dw2wrigh/noise-toaster/README.md

# noise-toaster
My version of the MFOS Noise Toaster
