dw2wrigh/noise-toaster/Documents/Parts List.xlsx

Qty. | Description | Value | Actual Part | Designators
2 | LM324 Quad Low Power Op Amp | LM324 | LM324DT | U1, U2
1 | LM386N4 (or N3) Low Voltage Audio Power Amp | LM386 | LM386MX | U3
1 | 2N3906 | 2N3906 | MMBT3906 | Q10
4 | 2N5457 N Channel JFET | 2N5457 | MMBF5457 | Q1, Q7, Q8, Q9
5 | Transistor NPN 2N3904 | 2N3904 | MMBT3904 | Q2, Q3, Q4, Q5, Q6
3 | 1N914 High Speed Sw. Diode | 1N914 | 1N4448WS | D1, D2, D3
1 | General Purpose Red LED | LED | C503B-RAS-CA0C0AA1 | LED1
7 | Linear Taper Potentiometer | 100K | PDB181-E420K-104B-ND‎ | R1, R13, R20, R28, R29, R38, R66
3 | Linear Taper Potentiometer | 1M | ‎PDB181-E420K-105B-ND‎ | R49, R51, R53
3 | Resistor 1/4 Watt 5% | 2M | ‎ESR03EZPJ | R5, R16, R30
1 | Resistor 1/4 Watt 5% | 300K | ‎ESR03EZPJ | R7
1 | Resistor 1/4 Watt 5% | 36K | ‎ESR03EZPJ | R21
1 | Resistor 1/4 Watt 5% | 15K | ‎ESR03EZPJ | R18
2 | Resistor 1/4 Watt 5% | 39K | ‎ESR03EZPJ | R39, R40
3 | Resistor 1/4 Watt 5% | 3K | ‎ESR03EZPJ | R48, R65, R70
5 | Resistor 1/4 Watt 5% | 4.7K | ‎ESR03EZPJ | R22, R23, R37, R42, R54
2 | Resistor 1/4 Watt 5% | 4.7M | ‎ESR03EZPJ | R33, R35
3 | Resistor 1/4 Watt 5% | 470K | ‎ESR03EZPJ | R10, R19, R41
2 | Resistor 1/4 Watt 5% | 47K | ‎ESR03EZPJ | R27, R36
2 | Resistor 1/4 Watt 5% | 75K | ‎ESR03EZPJ | R2, R56
1 | Resistor 1/4 Watt 5% | 820 ohm | ‎ESR03EZPJ | R50
1 | Resistor 1/4 Watt 5% | 10 ohms | ‎ESR03EZPJ | R69
12 | Resistor 1/4 Watt 5% | 100K | ‎ESR03EZPJ | R14, R24, R25, R31, R44, R45, R47, R55, R58, R59, R60, R67
11 | Resistor 1/4 Watt 5% | 10K | ‎ESR03EZPJ | R4, R6, R9, R12, R15, R17, R26, R32, R52, R61, R62
2 | Resistor 1/4 Watt 5% | 150K | ‎ESR03EZPJ | R63, R64
1 | Resistor 1/4 Watt 5% | 3M | ‎ESR03EZPJ | R34
2 | Resistor 1/4 Watt 5% | 1M | ‎ESR03EZPJ | R8, R46
1 | Resistor 1/4 Watt 5% | 200 ohm | ‎ESR03EZPJ | R57
2 | Resistor 1/4 Watt 5% | 20K | ‎ESR03EZPJ | R68, Extra for optional R56 replacement.
1 | Resistor 1/4 Watt 5% | 270K | ‎ESR03EZPJ | R3
1 | Resistor 1/4 Watt 5% | 27K | ‎ESR03EZPJ | R43
1 | Resistor 1/4 Watt 5% | 2K | ‎ESR03EZPJ | R11
2 | Capacitor Aluminum Bipolar (non polarized) | 1uF | EEE-1HA010NR | C17, C21
3 | Capacitor Ceramic | .001uF | 885012206083‎ | C2, C9, C10
1 | Capacitor Ceramic | .047uF | CL10B473KB8NNNC‎ | C24
8 | Capacitor Ceramic | .1uF | CL10B104KB8NNNC‎ | C3, C4, C5, C7, C8, C11, C12, C20
1 | Capacitor Ceramic | 100pF | 885012206077‎ | C1
1 | Capacitor Ceramic | .01uF | 885012206089 | C6
3 | Capacitor Electrolytic | 10uF | 865080440002 | C13, C14, C25
2 | Capacitor Electrolytic | 1uF | ‎865060640001‎ | C16, C19
1 | Capacitor Electrolytic | 4.7uF | ‎865080640004‎ | C18
1 | Capacitor Electrolytic Radial Lead 0.2" Spacing | 220uF | UCL1C221MCL1GS‎ | C22
3 | Capacitor Electrolytic Radial Lead 0.2" Spacing | 470uF | 865080353015‎ | C15, C23, C26
1 | Speaker 2 1/4 inch 8 ohm | 8 ohm 1W | ‎K 50 FL - 8 OHM‎ | SPK1
2 | Switch SPDT (Center Off) Mini Toggle | SPDT | 100SP3T1B1M1QEH | S3, S6
2 | Switch SPDT Mini Toggle | SPDT | 100SP1T1B1M1QEH | S8, S9
6 | Switch SPST Mini Toggle | SPST | 100SP1T1B1M1QEH | S1, S2, S4, S5, S7, S11
1 | Switch SPST N.O. Pushbutton | SPST | ‎PS1024ARED‎ | S10
1 | Jack 1/4" With NC Switch to Tip |  | ‎35PM2A‎ | J1
1 | Battery | 9V Battery | BX0023 | B1
