dw2wrigh/noise-toaster/Documents/Front Panel RefDes.pdf

### Voltage Controlled Oscillator

### Voltage Controlled Low Pass Filter

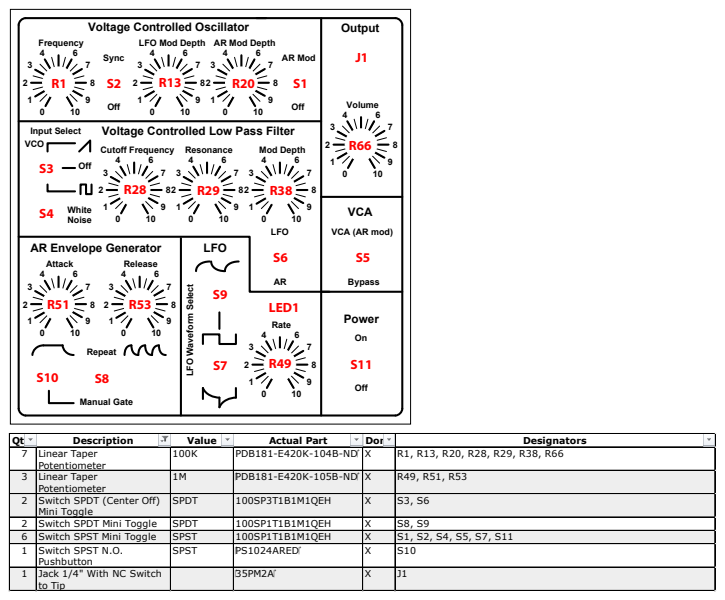
[picture p4: page 1]

Qty. | Description | Value | Actual Part | Done | Designators
7 | Linear Taper Potentiometer | 100K | PDB181-E420K-104B-ND‎ | X | R1, R13, R20, R28, R29, R38, R66
3 | Linear Taper Potentiometer | 1M | ‎ PDB181-E420K-105B-ND‎ | X | R49, R51, R53
2 | Switch SPDT (Center Off) Mini Toggle | SPDT | 100SP3T1B1M1QEH | X | S3, S6
2 | Switch SPDT Mini Toggle | SPDT | 100SP1T1B1M1QEH | X | S8, S9
6 | Switch SPST Mini Toggle | SPST | 100SP1T1B1M1QEH | X | S1, S2, S4, S5, S7, S11
1 | Switch SPST N.O. Pushbutton | SPST | ‎ PS1024ARED‎ | X | S10
1 | Jack 1/4" With NC Switch to Tip | | ‎ 35PM2A‎ | X | J1
