dw2wrigh/noise-toaster/Documents/Laser Cutter/Art.pdf

### Voltage Controlled Oscillator Output

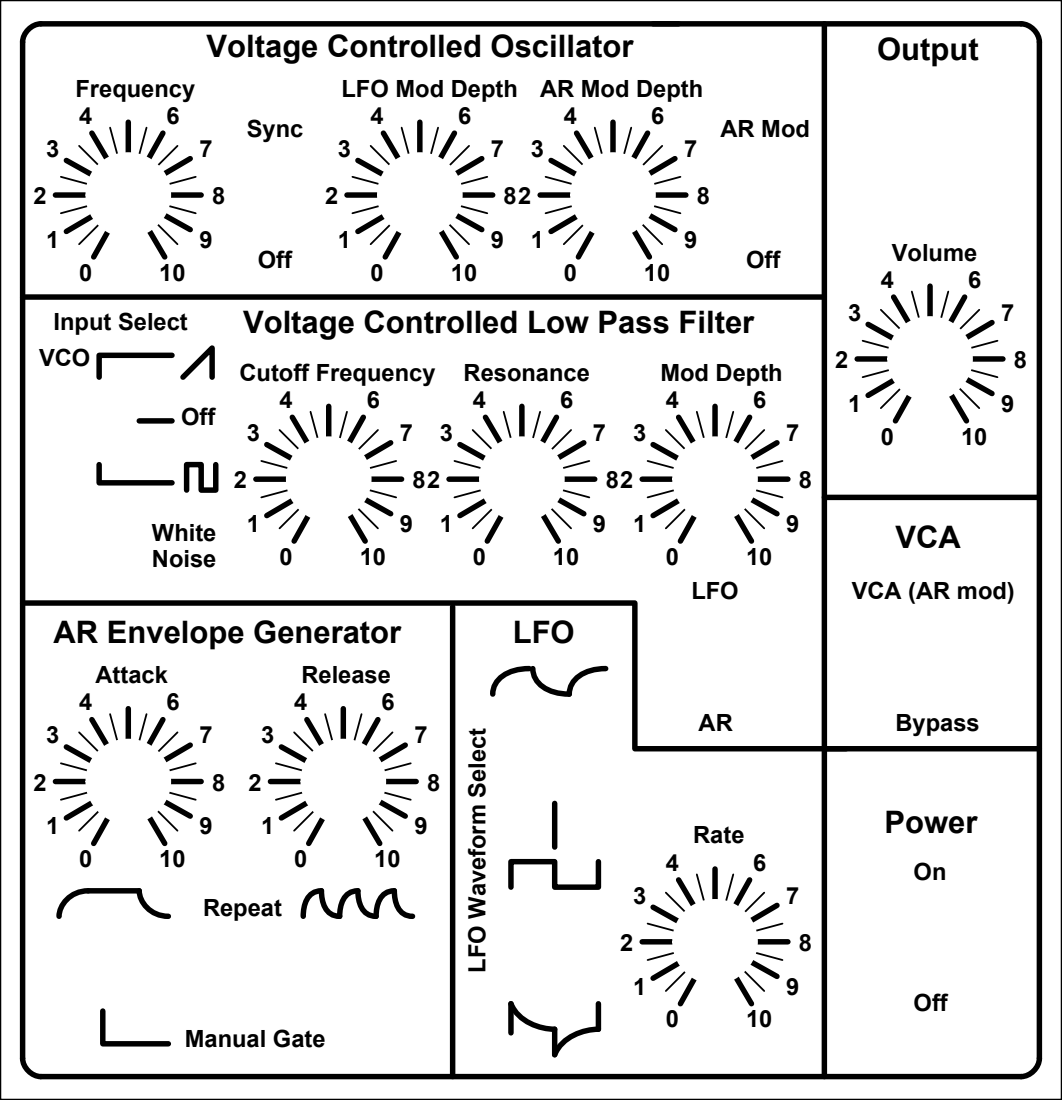
[picture p5: page 1]
LFO; Off; White Noise; VCA (AR mod); Bypass; VCO; Input Select; Sync; AR Mod; AR Envelope Generator; Power; Voltage Controlled Low Pass Filter; VCA; Manual Gate; Repeat; LFO Mod Depth; Cutoff Frequency; Resonance; Mod Depth; Rate; Volume; Release; AR Mod Depth; Frequency; Attack

LFO Waveform Select
