dw2wrigh/noise-toaster/Project Outputs for Noise Toaster/Noise Toaster Schematics.pdf

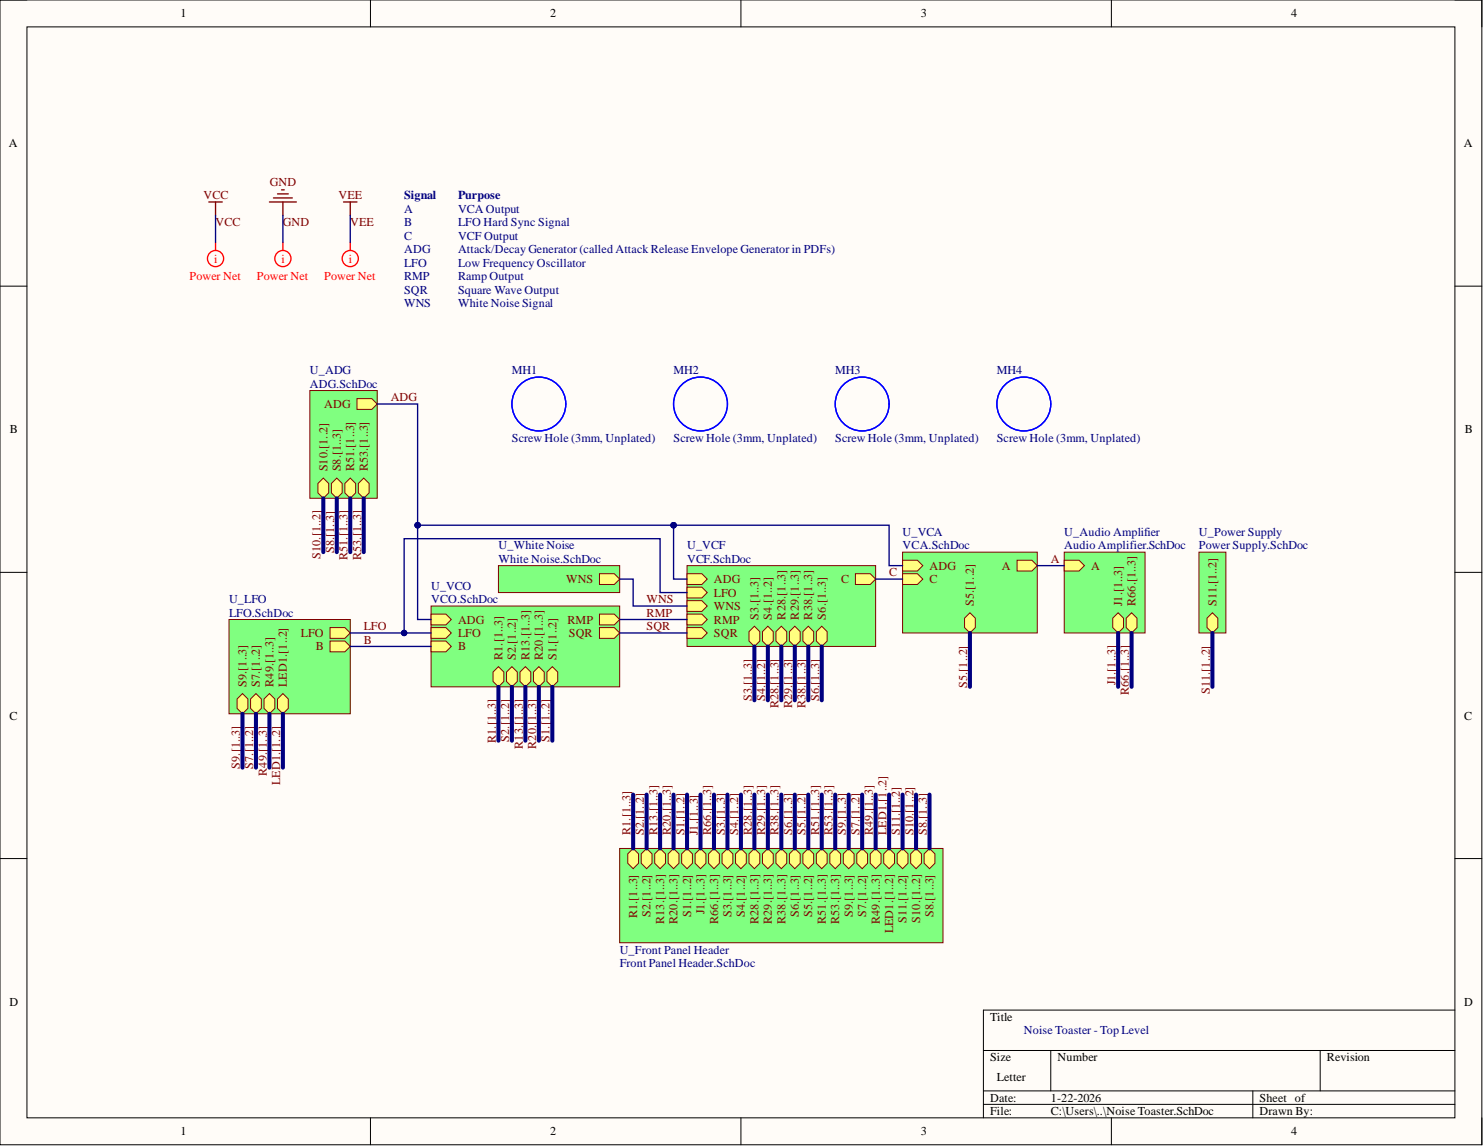
[picture p6: page 1]

VCA Output
LFO Hard Sync Signal
VCF Output
Attack/Decay Generator (called Attack Release Envelope Generator in PDFs)
Low Frequency Oscillator
Ramp Output
Square Wave Output
White Noise Signal

U_White Noise White Noise.SchDoc

U_VCF

U_Front Panel Header
Front Panel Header.SchDoc

Title
Noise Toaster - Top Level

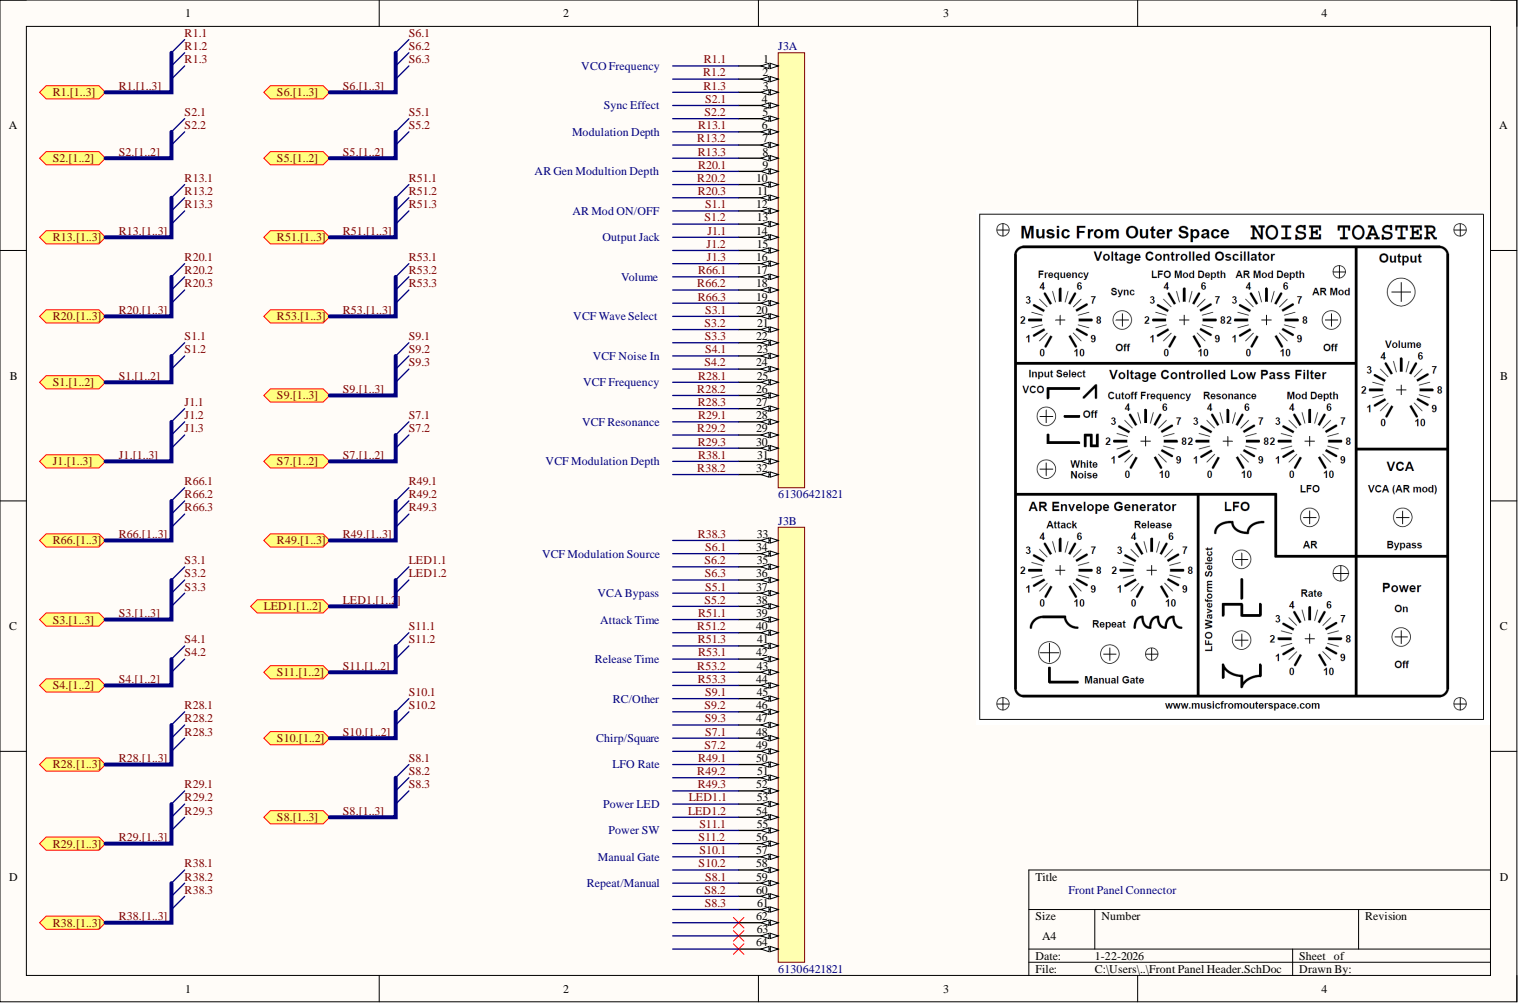
[picture p7: page 2]

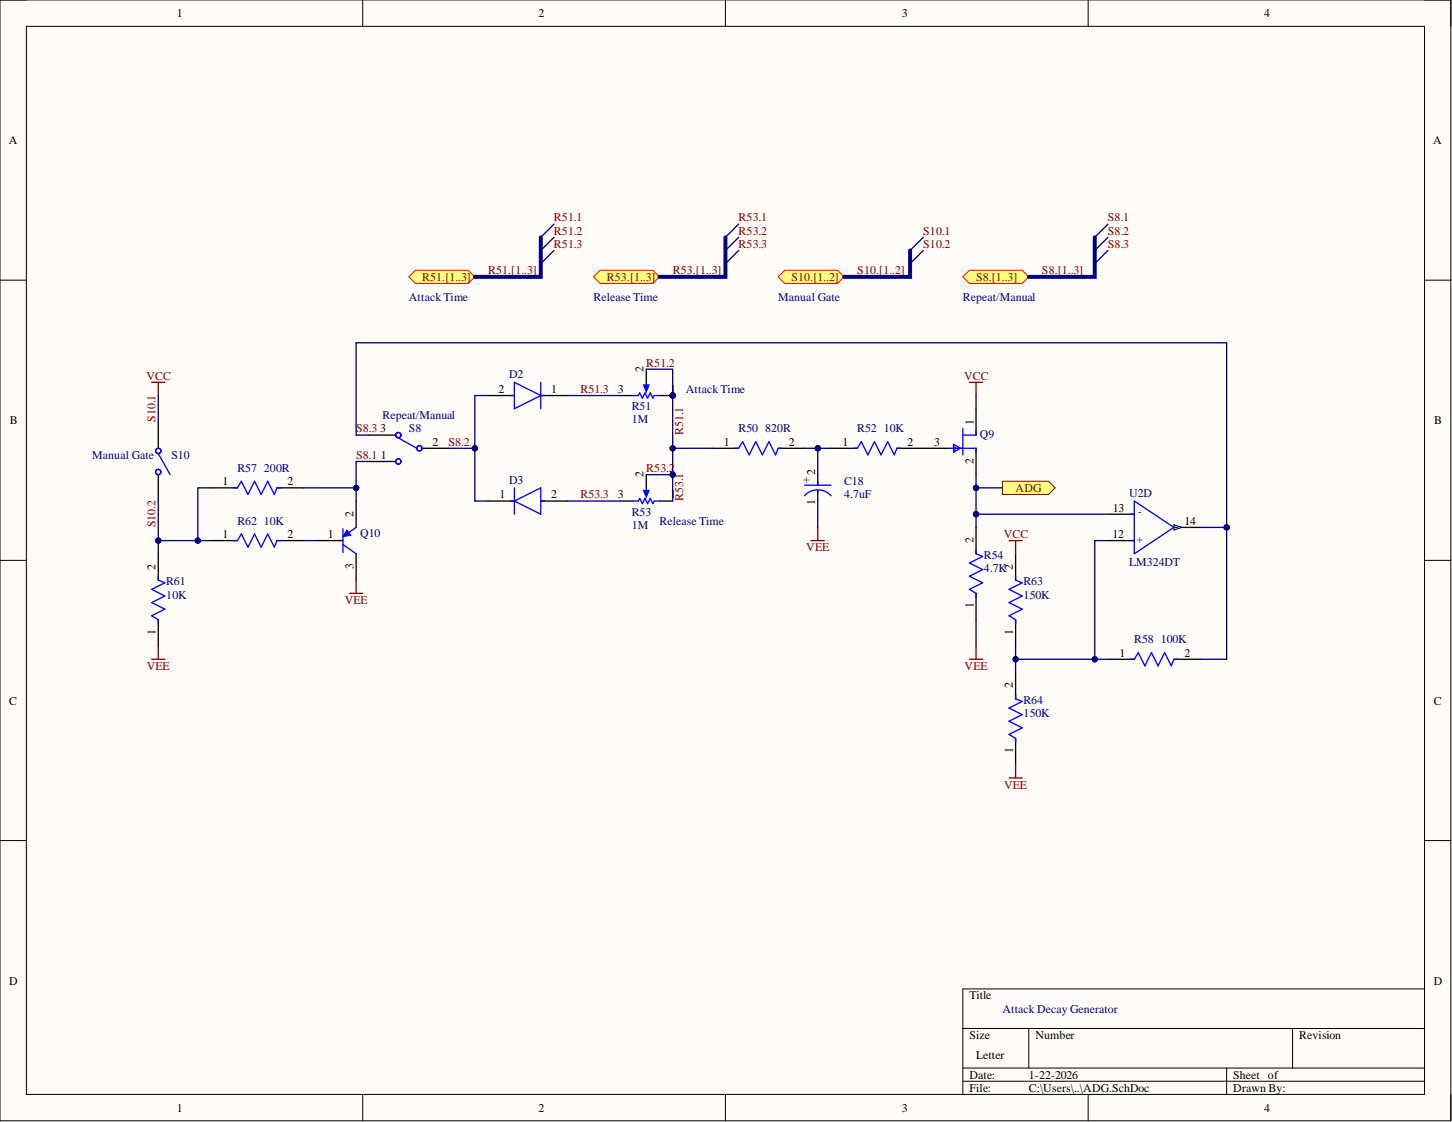
[picture p8: page 3]

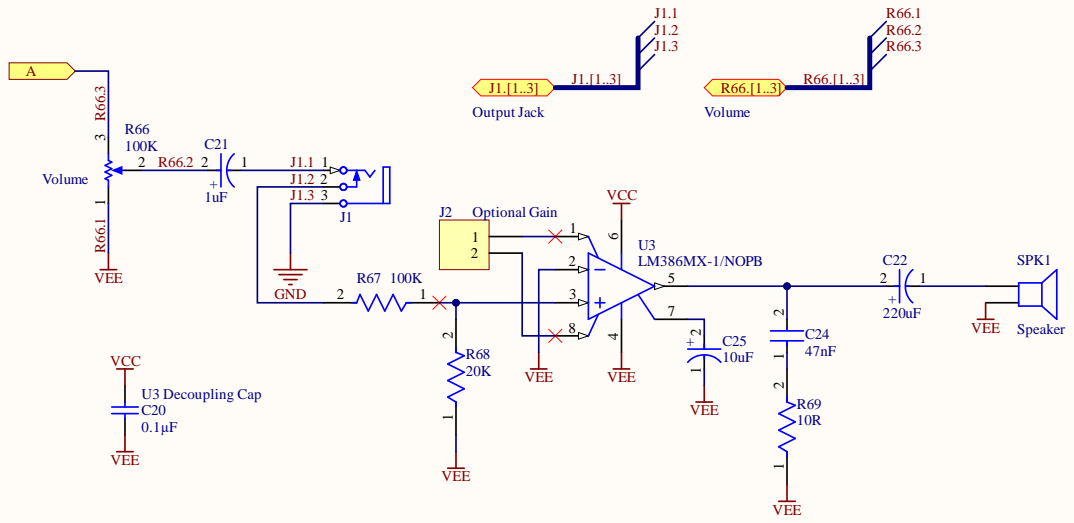
[picture p9: page 4]

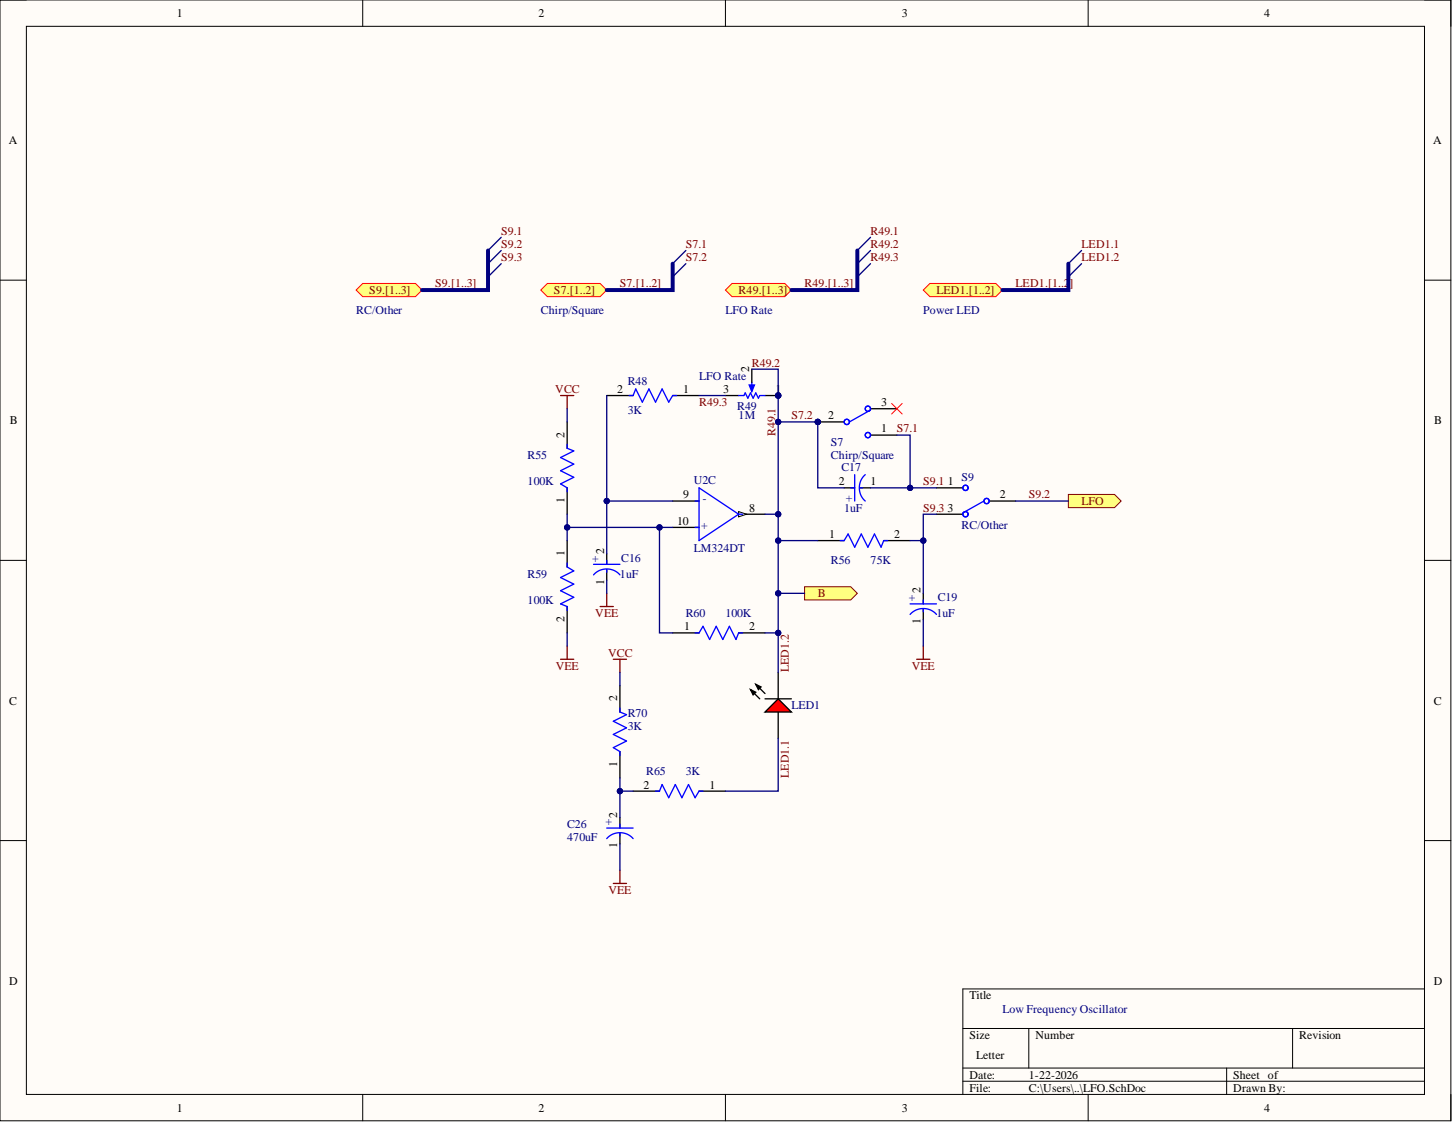
[picture p10: page 5]

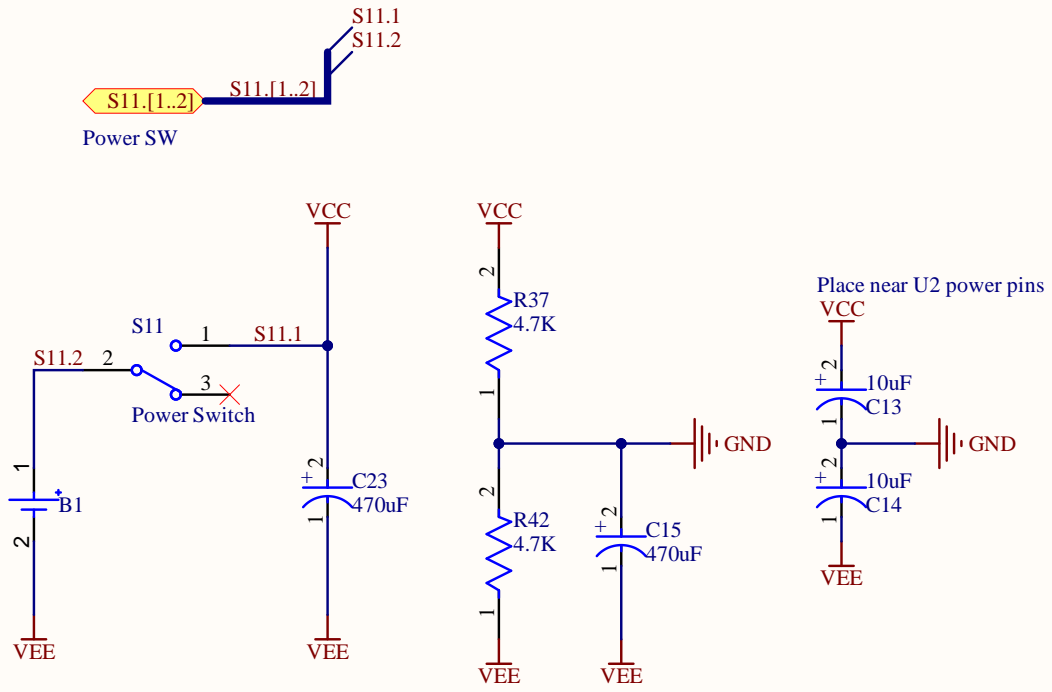
[picture p11: page 6]

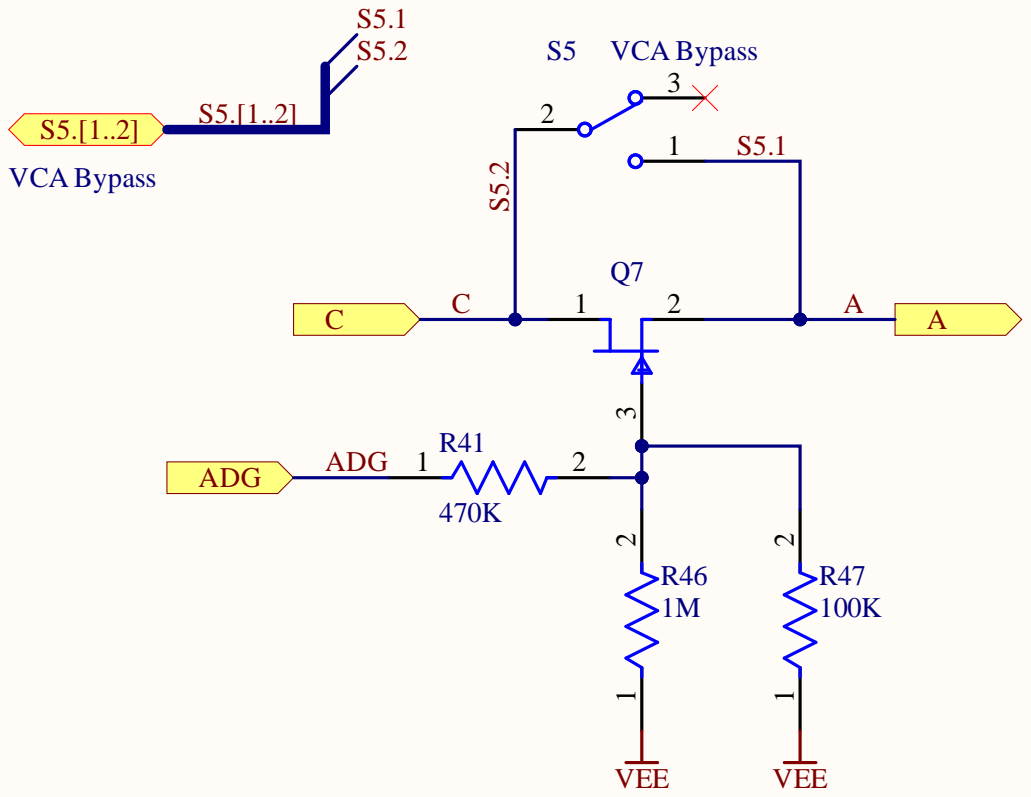
[picture p12: page 7]

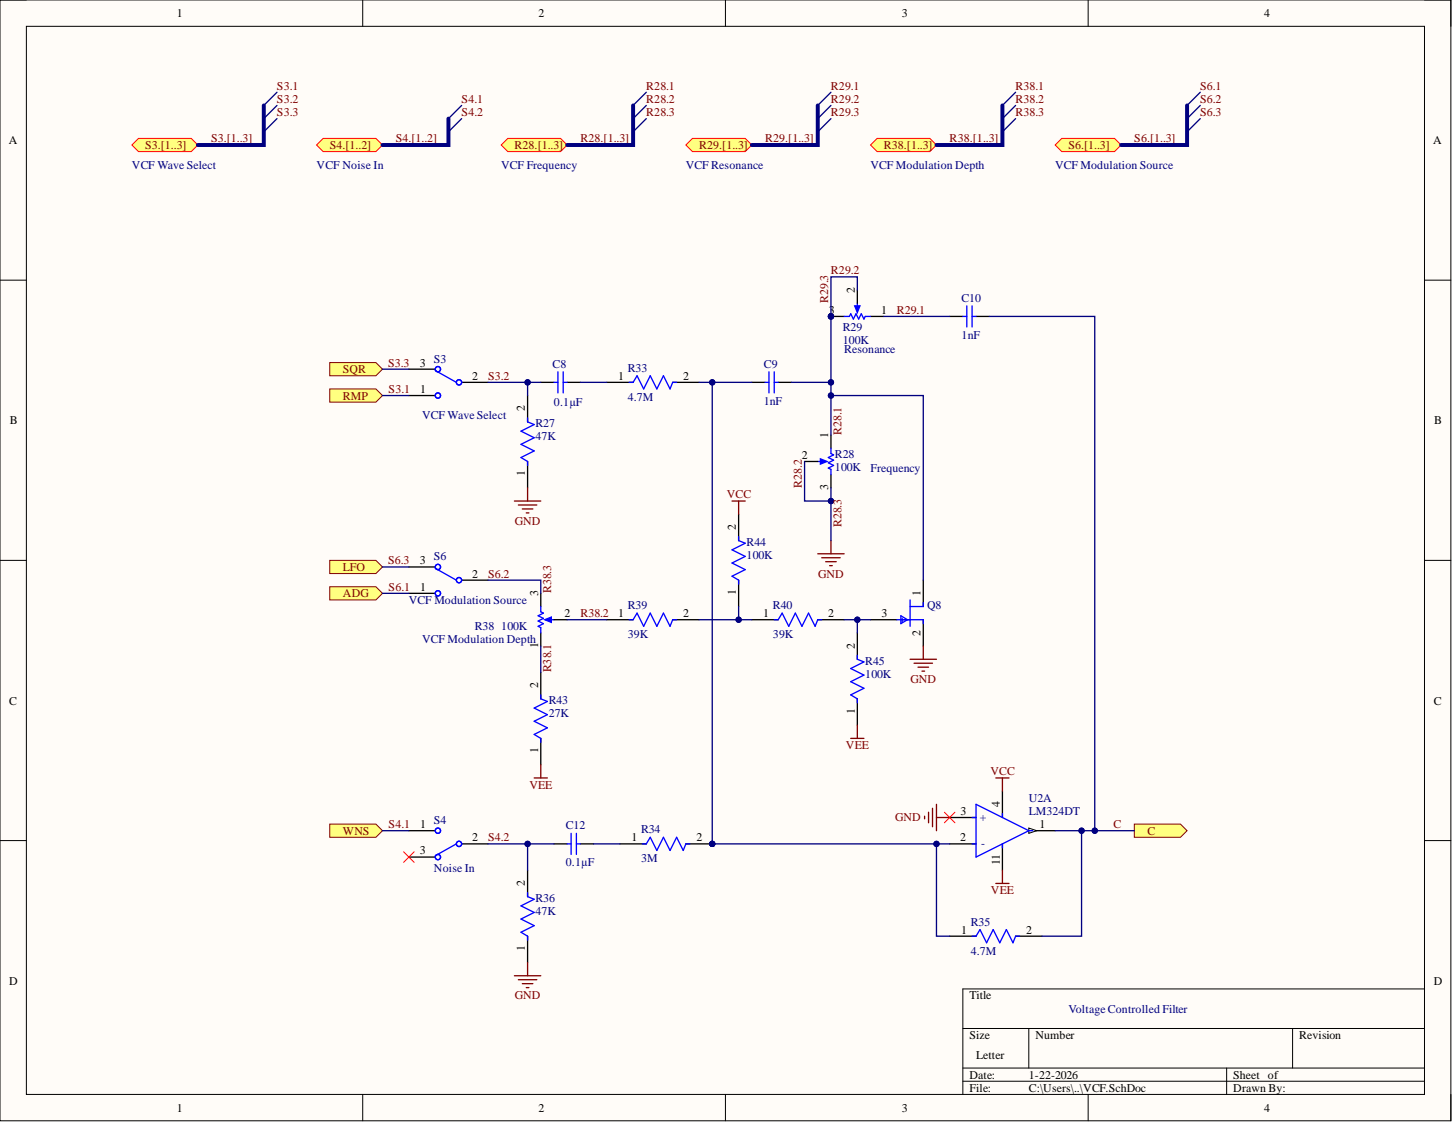
[picture p13: page 8]

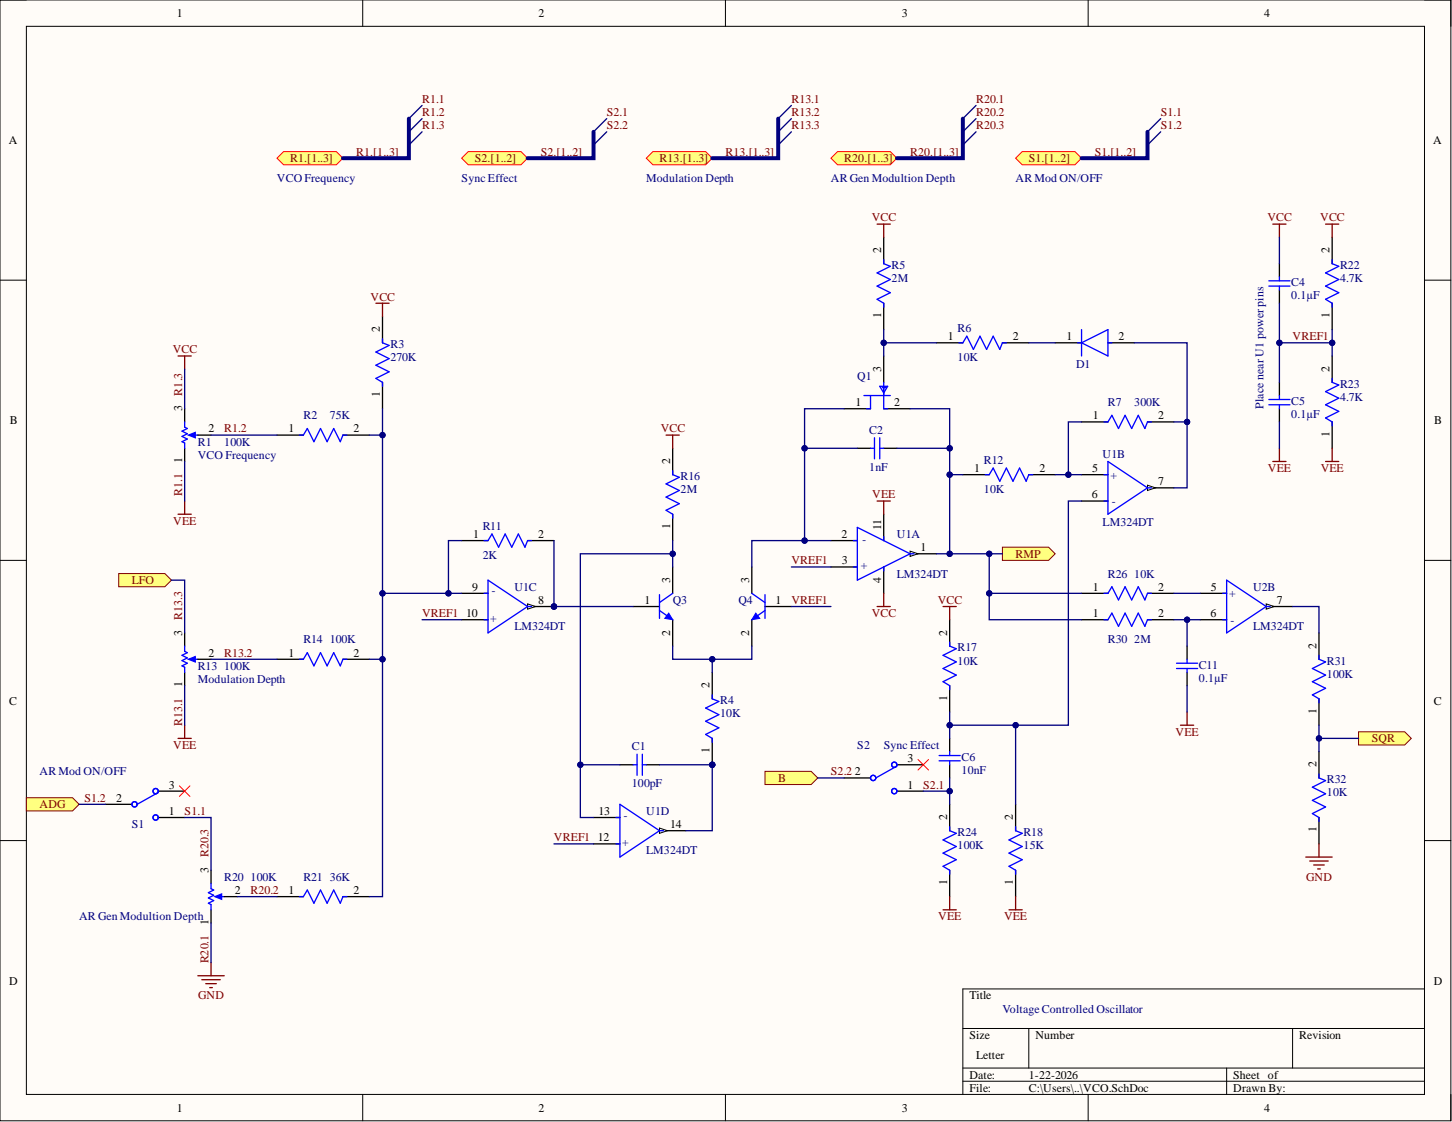
[picture p14: page 9]

Place near U1 power pins

AR Mod ON/OFF

AR Gen Modultion Depth

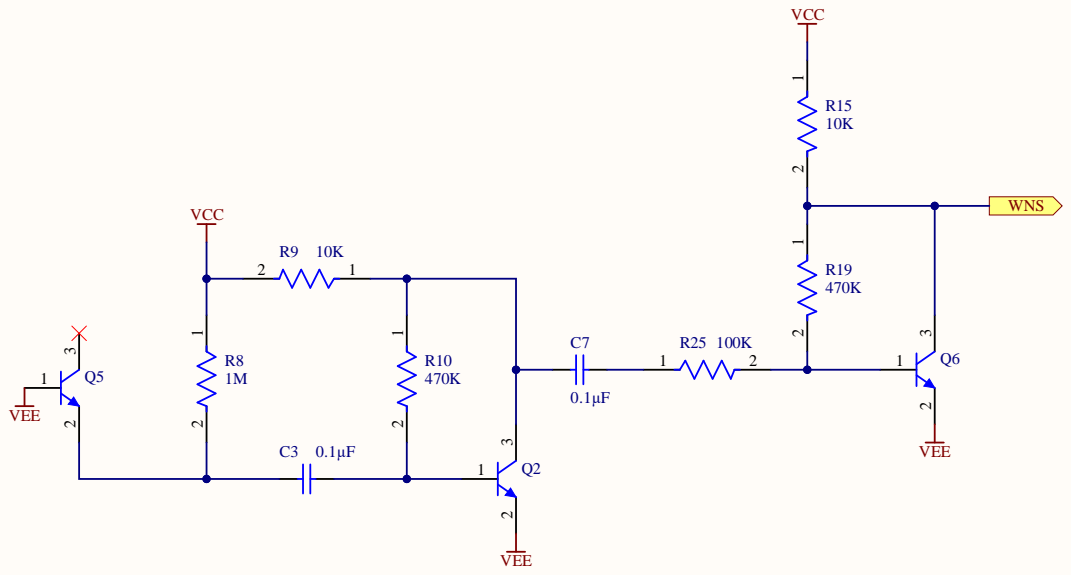
[picture p15: page 10]
