dw2wrigh/noise-toaster/Project Outputs for Noise Toaster/Composite Drawing.pdf

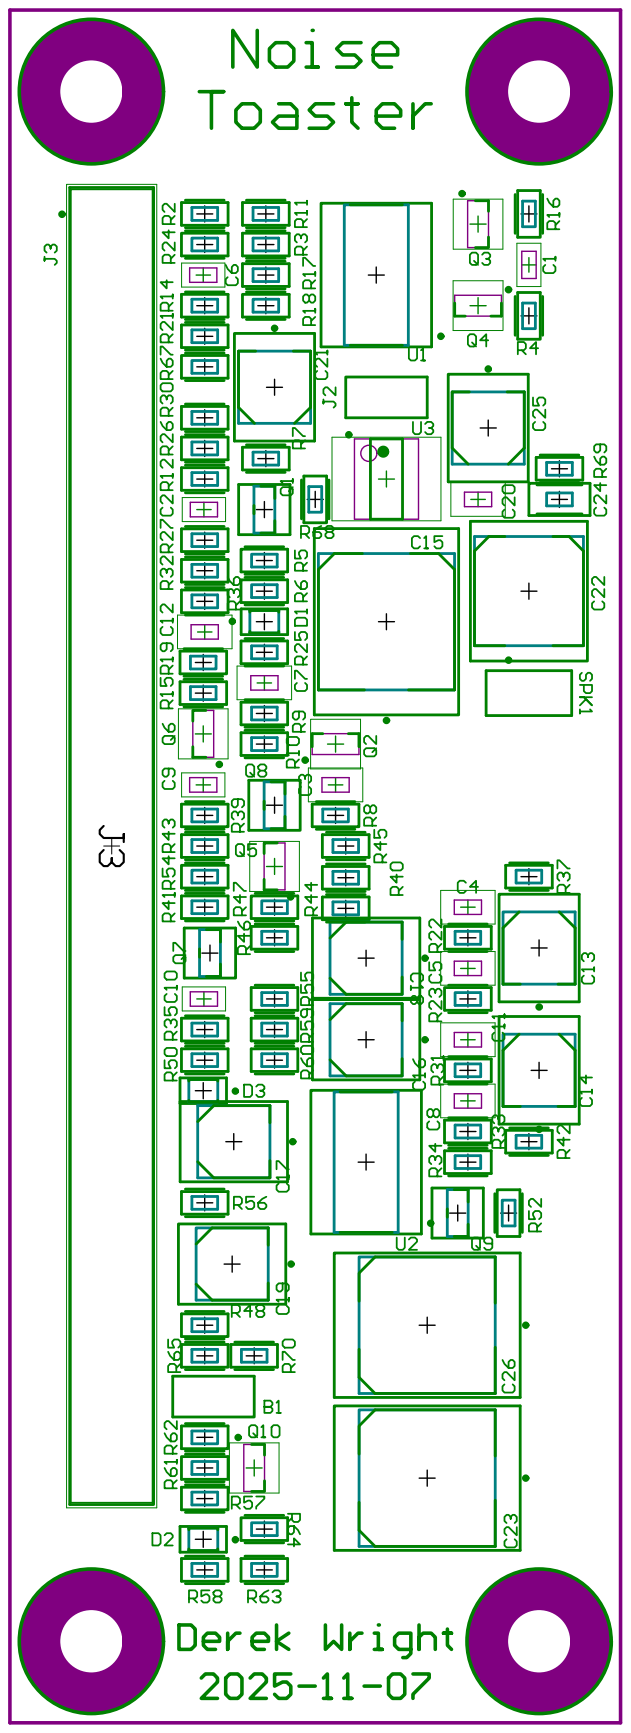
[picture p16: page 1]
