dw2wrigh/noise-toaster/Documents/Laser Cutter/Cutout.pdf

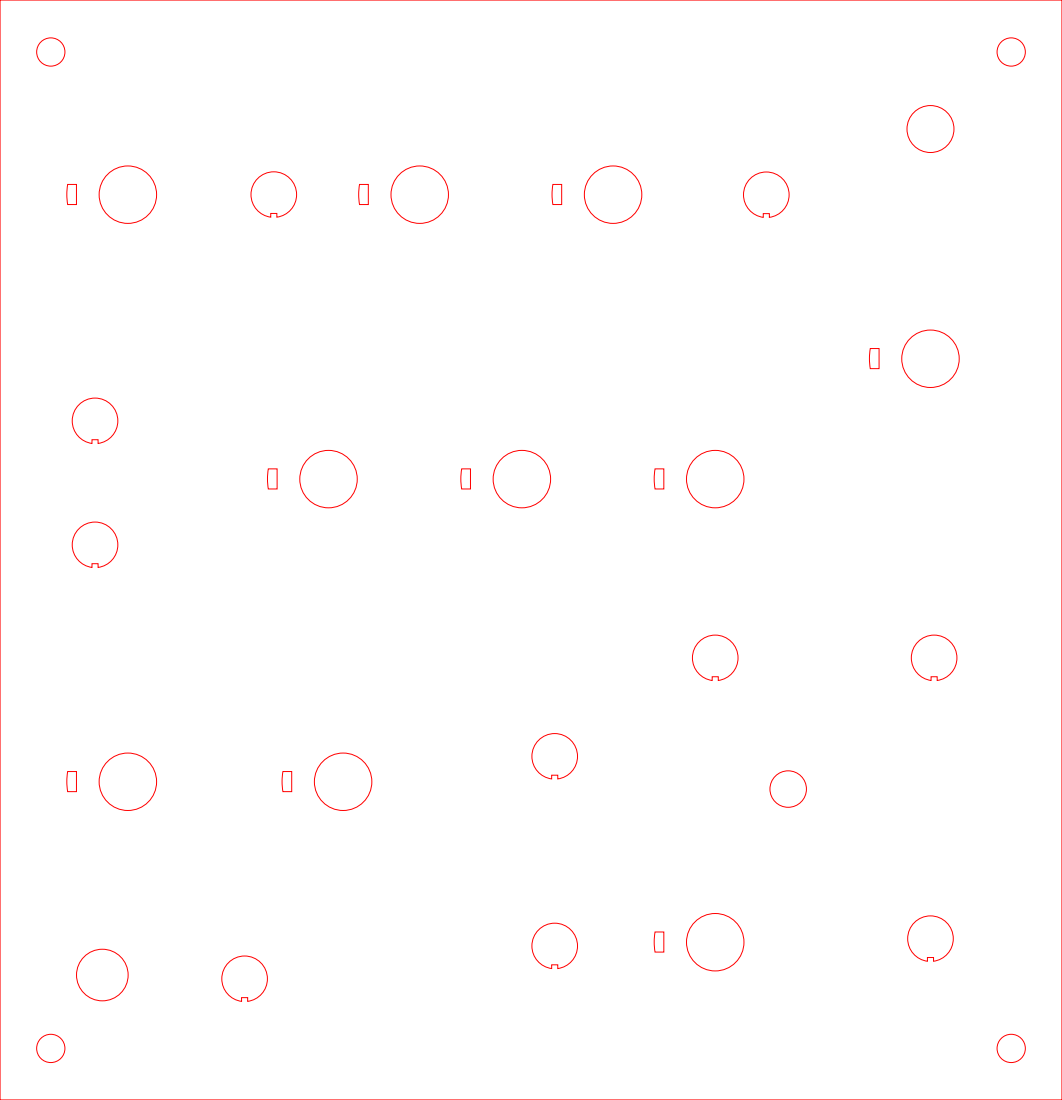
[picture p17: page 1]
