dw2wrigh/noise-toaster/Documents/Analysis/ADG TB.asc

V1: voltage; 4.5
V2: voltage; 4.5
V3: voltage; 1
V4: voltage; PULSE(0 1 500m 10u 10u 500m 1 8)
X1: ADG; PR51={PR51} PR53={PR53}
Named nets: VCC, VEE, 0, S10, S8, ADG
.tran 0 8 0 1m
.op
.param PR51=0.01 PR53=0.01
