dw2wrigh/noise-toaster/Documents/Analysis/ADG.asc

C18: cap; 4.7µ
D2: diode; 1N914
D3: diode; 1N914
Q9: njf; J113
Q10: pnp; 2N3906
R50: res; 820
R51: res; {RMIN + 1Meg*PR51}
R52: res; 10k
R53: res; {RMIN + 1Meg*PR53}
R54: res; 4.7k
R57: res; 200
R58: res; 100k
R61: res; 10k
R62: res; 10k
R63: res; 150k
R64: res; 150k
S8: spdt
S10: spdt
U2D: LT1014
Named nets: VCC, VEE, S10, S8, ADG, Q9G, Vp, Vo, ChDis
.include spdt.sub
S8 = 0: Automatic
S8 = 1: Manual via S10
 
S10: Manual ADG Gate
1Meg Pot
1Meg Pot
.param RMIN = 1
