dw2wrigh/noise-toaster/Documents/Analysis/Amplifier TB.asc

V1: voltage; 4.5
V2: voltage; 4.5
V3: voltage; SINE(0 1 100 0.01); AC 1
X1: Amplifier; PR66={PR66}
Named nets: VCC, VEE, 0, A, OUT
.tran 0 0.1 0 startup
.op
.param PR66=0.5
.options method=gear
.ac dec 10 0.1 1Meg
.step param PR66 0 1 0.1
