dw2wrigh/noise-toaster/Documents/Analysis/Amplifier.asc

C21: cap; 1µ
C22: cap; 220µ
C24: cap; 47n
C25: cap; 10µ
CM: cap; 137µ
LE: ind; 150µ; Rser=1m
LM: ind; 1m; Rser=1m
R66N: res; {RMIN + 100k*PR66}
R66P: res; {RMIN + 100k*(1-PR66)}
R67: res; 100k
R68: res; 20k
R69: res; 10
RE: res; 6.4
RM: res; 22
U1: LM386
Named nets: VCC, VEE, A, OUT
CHANGE: Improve low-freq response
.include LM386.sub
Speaker Model for 2056-K50FL-8OHM-ND
.param RMIN=1
