dw2wrigh/noise-toaster/Documents/Analysis/LFO TB.asc

V1: voltage; 4.5
V2: voltage; 4.5
V3: voltage; 1
V4: voltage; 0
X1: LFO; PR49VAL={PR49}
Named nets: VCC, VEE, 0, S9, S7, LFO, B
.tran 0 8 0 1m
.op
.param PR49=0.1
.step param PR49 0 1 0.1
