dw2wrigh/noise-toaster/Documents/Analysis/LFO.asc

C16: cap; 1µ
C17: cap; 1µ
C19: cap; 1µ
C26: cap; 470µ
LED1: LED; QTLP690C
R48: res; 3k
R49: res; {RMIN+ (1-PR49)*1Meg}
R55: res; 100k
R56: res; 75k
R59: res; 100k
R60: res; 100k
R65: res; 3k
R70: res; 3k
S7: spdt
S9: spdt
U2C: LT1014
Named nets: S7, S9, VCC, VEE, Vp, Vn, B, LFO
.param RMIN = 1
S7 = 0: Square
S7 = 1: Chirp
 
S9 = 0: Other
S9 = 1: RC
 
R49: LFO Frequency
.include spdt.sub
