dw2wrigh/noise-toaster/Documents/Analysis/NoiseToaster.asc

X1: ADG; PR51={PR51} PR53={PR53}
X2: LFO; PR49={PR49}
X3: VCO; PR1={PR1} PR13={PR13} PR20={PR20}
X4: WhiteNoise
X5: VCF
X6: VCA
X7: Amplifier; PR66={PR66}
Named nets: VCC, VEE, S1, S2, S3, S4, S5, S6, S7, S9, S8, S10, OUT, A, C, ADG, LFO, B, RMP, SQR, WNS
S1: VCO AR Mod Enable
0 = OFF
1 = ON
 
S2: VCO Sync Effect (via B)
0 = OFF
1 = ON
 
S3: VCF Wave Select
0   = Square
0.5 = None
1   = Ramp
 
S4: VCF White Noise In
0 = OFF
1 = ON
 
S5: VCA Enable
0 = Enabled
1 = Bypass
 
S6: VCF Modulation Source
0   = Low Frequency Oscillator
0.5 = None
1   = Attack Delay Generator
 
(S9, S7): LFO Output
00 = Square
01 = Chirp
1X = RC
 
S8: ADG Trigger
0 = Automatic Repeat
1 = Manual via S10
 
S10: ADG Manual Gate
R1:  VCO Frequency
R13: VCO LFO Modulation Depth
R20: VCO AR Modulation Depth
 
R51: ADG Attack Time
R53: ADG Release Time
 
R49: LFO Rate
 
R28: VCF Cutoff Frequency
R29: VCF Resonance
R38: VCF Modulation Depth
 
R66: Volume
.param PR51 = 0.1
.param PR53 = 0.1
.param PR1 = 0.6
.param PR13 = 0.1
.param PR20 = 1
.options method=gear
.options reltol=0.002 abstol=1n vntol=1u
.param PR28 = 1.0
.param PR29 = 0.9
.param PR38 = 1
.param PR49 = 0.9
.param PR66 = 1.0
.param S1v = 0
.param S2v = 0
.param S3v = 0
.param S4v = 0
.param S5v = 1
.param S6v = 0
.param S7v = 0
.param S8v = 1
.param S9v = 0
.param S10v = 0
.param VBATT = 9
V1 VCC 0 {VBATT/2}
V2 VEE 0 {-VBATT/2}
B_S1  S1  0 V={S1v}
B_S2  S2  0 V={S2v}
B_S3  S3  0 V={S3v}
B_S4  S4  0 V={S4v}
B_S5  S5  0 V={S5v}
B_S6  S6  0 V={S6v}
B_S7  S7  0 V={S7v}
B_S8  S8  0 V={S8v}
B_S9  S9  0 V={S9v}
B_S10 S10 0 V={S10v}
.op
.tran 1 startup
