dw2wrigh/noise-toaster/Documents/Analysis/SPDT TB.asc

R1: res; 100
S1: spdt
V1: voltage; 4.5
V2: voltage; 4.5
V3: voltage; PWL(0 0 1 0 2 1 3 1 4 0 5 0 5.001 0.5 6 0.5 6.001 1)
Named nets: VCC, VEE, 0, S1, OUT
.tran 0 10 0 startup
.op
.options method=gear
.include spdt.sub
