dw2wrigh/noise-toaster/Documents/Analysis/VCA TB.asc

R1: res; 10k
V1: voltage; 4.5
V2: voltage; 4.5
V3: voltage; PWL(0 -4.5 5m -4.5 15m 4.5 20m 4.5)
V4: voltage; SINE(0 10m 1k 0)
V5: voltage; PULSE(0 0 10m 10u 10u 10m 20m)
X1: VCA
Named nets: VCC, VEE, 0, ADG, C, S5, A
.tran 0 20m 0 1u
.op
