dw2wrigh/noise-toaster/Documents/Analysis/VCA.asc

J1: njf; J113
R41: res; 470k
R46: res; 1Meg
R47: res; 100k
S5: spdt
Named nets: VEE, ADG, C, A, S5, G
.include spdt.sub
S5 = 0: VCA Enabled
S5 = 1: VCA Bypass
