dw2wrigh/noise-toaster/Documents/Analysis/VCF TB.asc

V1: voltage; 4.5
V2: voltage; 4.5
V3: voltage; 0.5
V4: voltage; 0
V5: voltage; 0
V6: voltage; 0; AC 4
V7: voltage; 0
V8: voltage; 0
V9: voltage; {VDC1}
V10: voltage; 0
X1: VCF; PR28={PR28} PR29={PR29} PR38={PR38}
Named nets: VCC, VEE, 0, S4, S3, RMP, SQR, S6, LFO, ADG, WNS, C
.tran 0 1 0 startup
.op
.param PR28=0 PR29=0.9 PR38=1
.options method=gear
.ac dec 10 0.1 1Meg
.step param VDC1 -1 2.5 0.1
.meas AC gpk MAX MAG(V(C))
.meas AC fhi WHEN MAG(V(C))=0.707*gpk FALL=1
