dw2wrigh/noise-toaster/Documents/Analysis/VCF.asc

C8: cap; 0.1µ
C9: cap; 1n
C10: cap; 1µ
C12: cap; 0.1µ
Q8: njf; J113
R27: res; 47k
R28: res; {RMIN + 100k*(1-PR28)}
R29: res; {RMIN + 100k*(1-PR29)}
R33: res; 4.7Meg
R34: res; 3Meg
R35: res; 4.7Meg
R36: res; 47k
R38N: res; {RMIN + 100k*PR38}
R38P: res; {RMIN + 100k*(1-PR38)}
R39: res; 39k
R40: res; 39k
R43: res; 27k
R44: res; 100k
R45: res; 100k
S3: spdt
S4: spdt
S6: spdt
U2A: LT1014
Named nets: S3, VCC, VEE, SQR, RMP, LFO, ADG, WNS, S4, S6, 0, C, S3IN, S4IN, Q8G
S3: VCF Wave Select
S3 = 0: Square
S3 = 0.5: None
S3 = 1: Ramp
 
S4: Noise In
S4 = 0: None
S4 = 1: White Noise
 
S6: VCF Modulation Source
S6 = 0:   Low Frequency Oscillator
S6 = 0.5: None
S6 = 1:   Attack Delay Generator
 
R28: Frequency
R29: Resonance
R38: Modulation Depth
.include spdt.sub
.param RMIN=1
CHANGE: R28 min needs ~5k in series, or investigate the zero causing high gain at low frequencies.
CHANGE: R28 ought to be logarithmic, and should probably max out around 20 kHz (currently more like 10 kHz).
CHANGE: WNS (S4 pathway) can probably be the same gain as the S3 pathway.
CHANGE: R29 should be logarithmic and its specific role should be clarified.
CHANGE: Control voltage useful input range and resulting cutoff frequency are very sensitive to Resonance.
CHANGE: R38 has an overly complicated relationship with V_G of Q8
CHANGE: Investigate a better tunable-resonance filter. Not sure why this one is designed with a quadratic zero.
CHANGE: This block could have one input, switched external to the circuit. Gain control could be in here, too, instead of VCA.
