dw2wrigh/noise-toaster/Documents/Analysis/VCO TB.asc

V1: voltage; 4.5
V2: voltage; 4.5
V3: voltage; 0
V4: voltage; 0
V5: voltage; PULSE(-4.5 4.5 0 1m 1m 50m 100m)
V6: voltage; 0
X1: VCO; PR1={PR1} PR13={PR13} PR20={PR20}
Named nets: VCC, VEE, 0, S2, S1, RMP, SQR, LFO, B
.tran 0 1 0 startup
.op
.param PR1=0.5 PR13=0 PR20=1
.options method=gear
