dw2wrigh/noise-toaster/Documents/Analysis/VCO.asc

C1: cap; 100p; Rser=0.1
C2: cap; 1n; Rser=0.1
C4: cap; 0.1µ; Rser=0.1
C5: cap; 0.1µ
C6: cap; 10n; Rser=0.1
C11: cap; 0.1µ; Rser=0.1
D1: diode; 1N914
Q1: njf; J113
Q3: npn; 2N3904
Q4: npn; 2N3904
R1: res; 10k
R1B: res; {RMIN + 100k*PR1}
R1T: res; {RMIN + 100k*(1-PR1)}
R2: res; 75k
R3: res; 270k
R5: res; 2Meg
R6: res; 10k
R7: res; 300k
R11: res; 2k
R12: res; 10k
R13B: res; {RMIN + 100k*PR13}
R13T: res; {RMIN + 100k*(1-PR13)}
R14: res; 100k
R16: res; 2Meg
R17: res; 10k
R18: res; 15k
R20B: res; {RMIN + 100k*PR20}
R20T: res; {RMIN + 100k*(1-PR20)}
R21: res; 36k
R22: res; 4.7k
R23: res; 4.7k
R24: res; 100k
R26: res; 10k
R30: res; 2Meg
R31: res; 100k
R32: res; 10k
S1: spdt
S2: spdt
U1: LT1014
U1A: LT1014
U1B: LT1014
U1C: LT1014
U1D: LT1014
Named nets: VEE, VCC, LFO, ADG, S1, VREF1, RMP, B, S2, 0, SQR, ViM4, Vo1, ViM3, Vo4, Q1g, Vo2M, Q34E, VCS, ViM1
S1 = 0: AR Mod OFF
S1 = 1: AR Mod ON
 
S2 = 0: Sync Effect OFF
S2 = 1: Sync Effect ON
.include spdt.sub
.param RMIN=1
