dw2wrigh/noise-toaster/Documents/Analysis/WhiteNoise TB.asc

V1: voltage; 4.5
V2: voltage; 4.5
X1: WhiteNoise
Named nets: VCC, VEE, 0, WNS
.tran 0 10m 0 1u
.op
