dw2wrigh/noise-toaster/Documents/Analysis/WhiteNoise.asc

B1: bi; I=(70.7n)*white(1e6*time)
C3: cap; 0.1µ
C7: cap; 0.1µ
Q2: npn; 2N3904
Q5: npn; 2N3904
Q6: npn; 2N3904
R8: res; 1Meg
R9: res; 10k
R10: res; 470k
R15: res; 10k
R19: res; 470k
R25: res; 100k
Named nets: VEE, VCC, V_o1, V_o2, WNS, Q2B, Q6B
