dw2wrigh/noise-toaster/(list of files, drawings)

Other design files:
ADG.SchDoc
Audio Amplifier.SchDoc
Front Panel Header.SchDoc
LFO.SchDoc
Noise Toaster.PcbDoc
Noise Toaster.PrjPcb
Noise Toaster.SchDoc
Power Supply.SchDoc
VCA.SchDoc
VCF.SchDoc
VCO.SchDoc
White Noise.SchDoc
