dw2wrigh/noise-toaster/(commit log)

2026-02-23 Added v1 docs
    [ADG.SchDoc, Audio Amplifier.SchDoc, Front Panel Header.SchDoc, LFO.SchDoc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]
2026-04-20 Corrected errors and full LTSpice model
    [ADG.SchDoc, Front Panel Header.SchDoc, Noise Toaster.PcbDoc, Noise Toaster.SchDoc, VCF.SchDoc, VCO.SchDoc, White Noise.SchDoc]
